sryburn/brewhoohoo-photon/README.md

A particle photon based HERMS brewery controller with 3D printed encousure.
WORK IN PROGRESS
