sryburn/brewhoohoo-photon/enclosure/BrewHooHoo_Case.obj

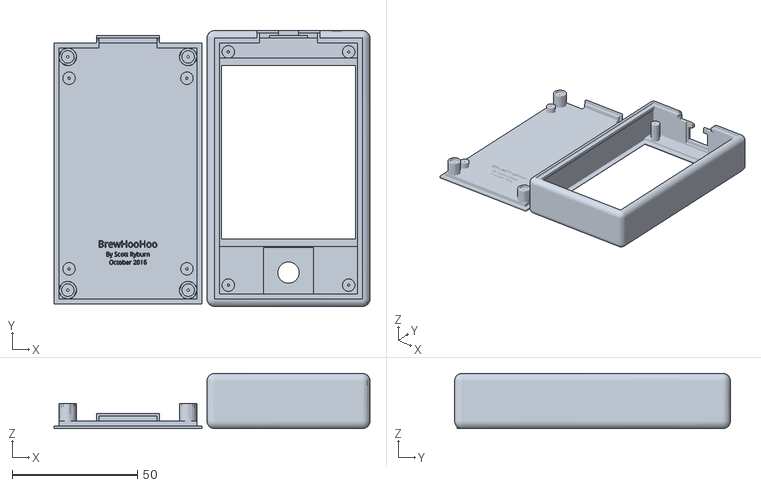
[picture p1: CAD file, 2017-02-18]
enclosure/BrewHooHoo_Case.obj
126.0 x 110.0 x 22.0
