sryburn/brewhoohoo-photon/schematics/relay_interface.pdf

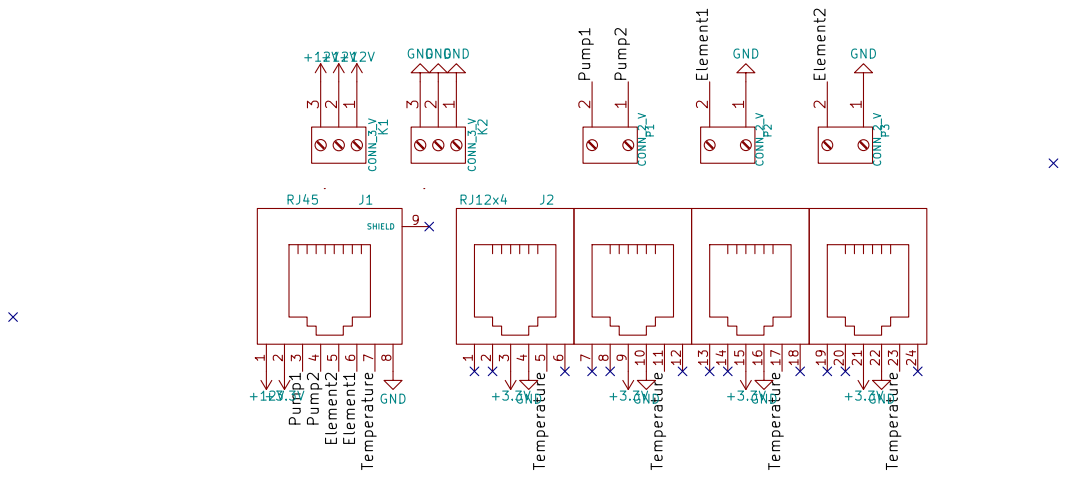
[picture p2: page 1]

File: brewbot_control_interface.sch Sheet: / github.com/sryburn

Id: 1/1 Title: BrewHooHoo Relay Interface
