sryburn/brewhoohoo-photon/schematics/photon_controller.pdf

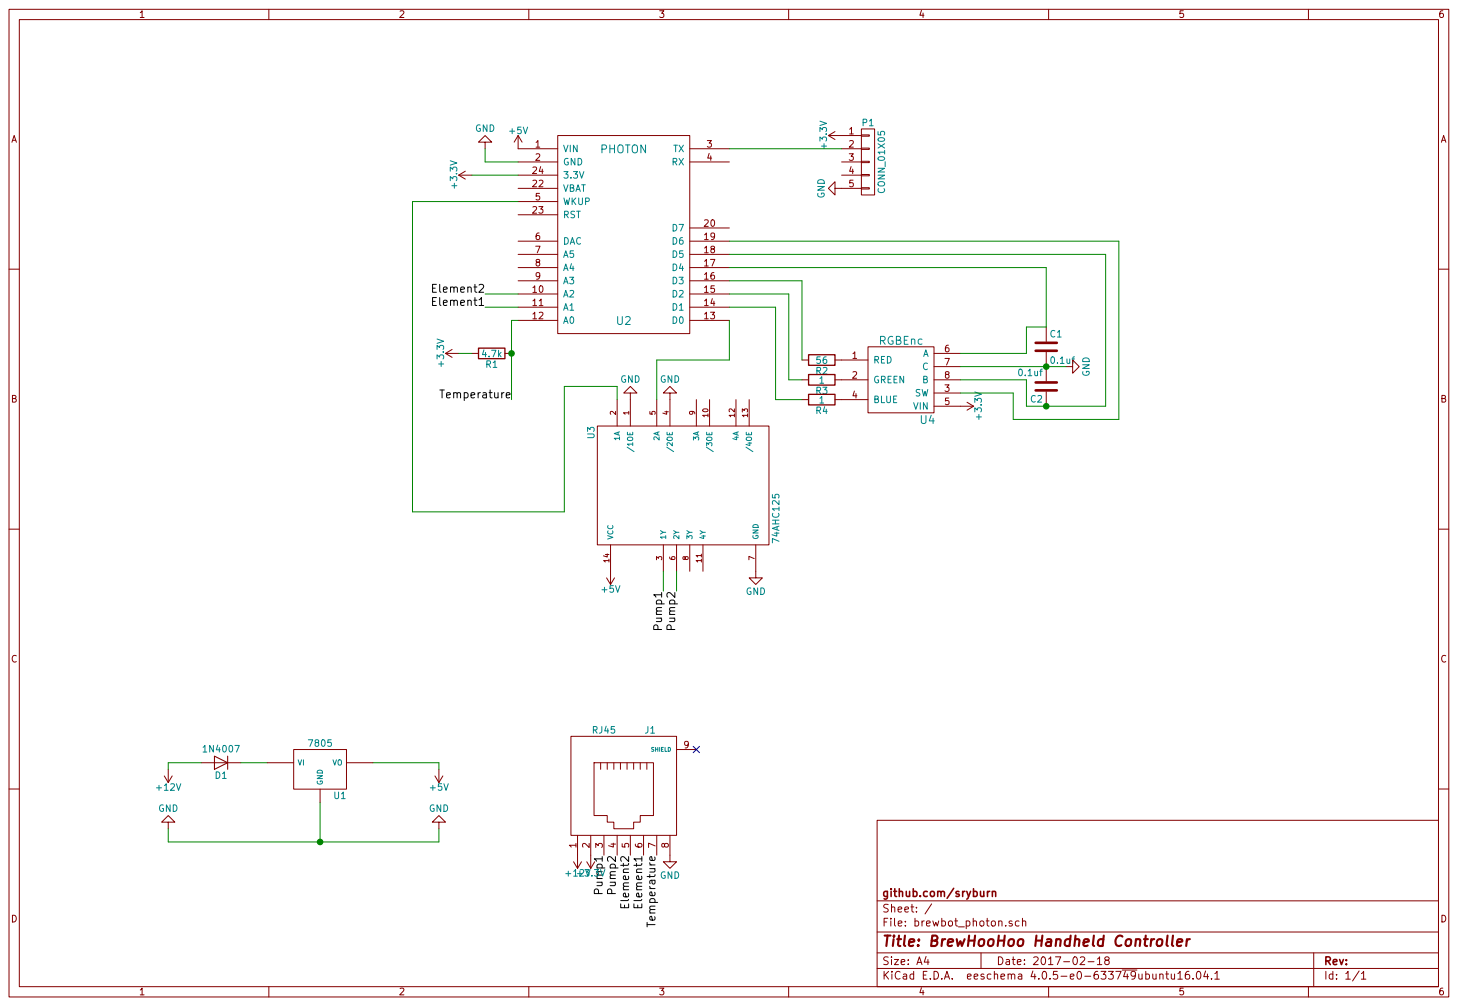
[picture p3: page 1]

File: brewbot_photon.sch Sheet: / github.com/sryburn

Id: 1/1 Title: BrewHooHoo Handheld Controller
