sryburn/brewhoohoo-photon/pcb/photon_controller.kicad_pcb

## KiCad design pcb/photon_controller.kicad_pcb (2017-02-18)

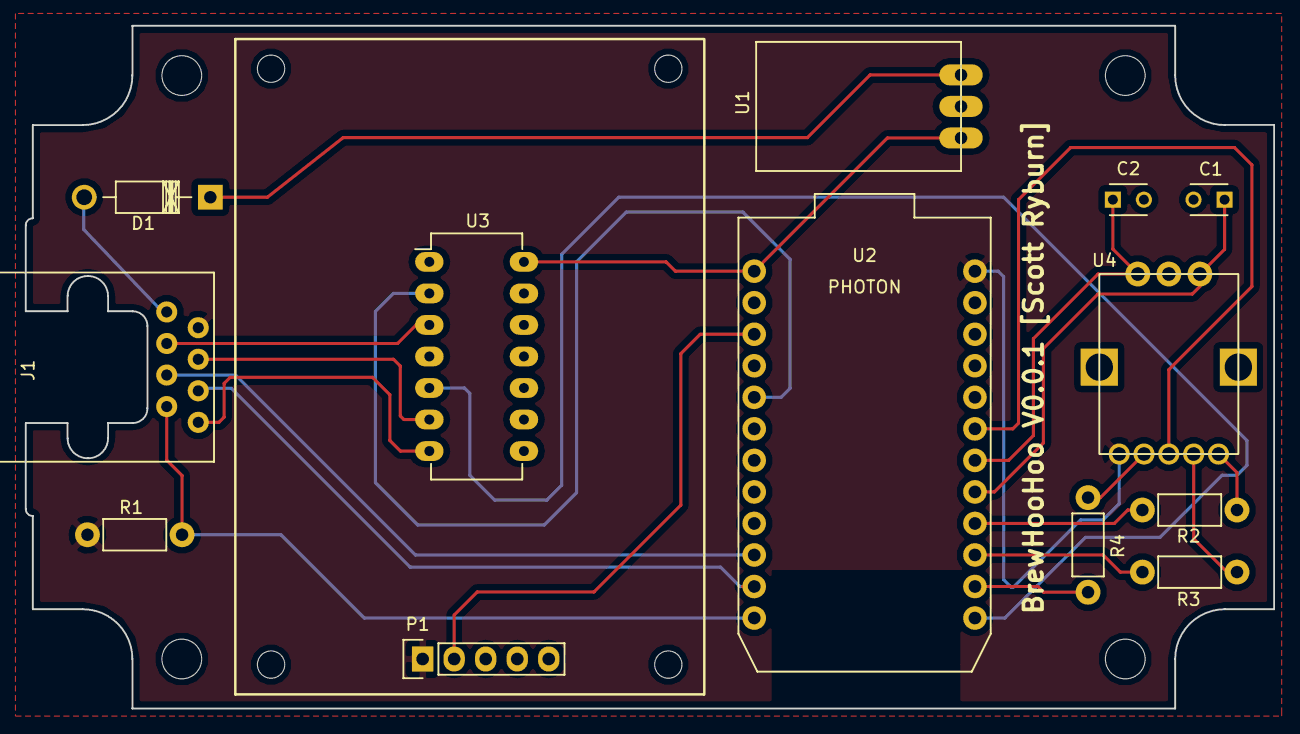
[picture p4: board photon_controller.kicad_pcb from above]

Board: 2 copper layers, 100.6 x 55.0 mm, 17 parts (0 on the bottom side), 22 nets.

Parts:
C1, C2: 0.1uf; C_Disc_D3_P2.5
D1: 1N4007; Diode_DO-41_SOD81_Horizontal_RM10
J1: RJ45; RJ45_cA121601-ND_slim
P1: CONN_01X05; Pin_Header_Straight_1x05
R1: 4.7k; Resistor_Horizontal_RM7mm
R2: 56; Resistor_Horizontal_RM7mm
R3, R4: 1; Resistor_Horizontal_RM7mm
U1: 7805; OKI-78SR-5-1.5-W36H-C
U2: PHOTON; photon
U3: 74AHC125; DIP-14_W7.62mm_LongPads
U4: RGBEnc; RGB_Encoder
h1, h2, h3, h4: MountingHole_2.2mm_M2

Connections:
+3V3: J1.2, P1.1, R1.2, U2.24, U4.5
+5V: U1.VO, U2.1, U3.14
+12V: D1.2, J1.1
/Element1: J1.6, U2.11
/Element2: J1.5, U2.10
/Pump1: J1.3, U3.3
/Pump2: J1.4, U3.6
/Temperature: J1.7, R1.1, U2.12
GND: C1.2, C2.2, J1.8, P1.5, U1.GND, U2.2, U3.1, U3.4, U3.7, U4.7
unnamed: C1.1, U2.17, U4.6
unnamed: C2.1, U2.18, U4.8
unnamed: D1.1, U1.VI
unnamed: P1.2, U2.3
unnamed: R2.1, U4.1
unnamed: R2.2, U2.16
unnamed: R3.1, U4.2
unnamed: R3.2, U2.15
unnamed: R4.1, U4.4
unnamed: R4.2, U2.14
unnamed: U2.5, U3.2
unnamed: U2.13, U3.5
unnamed: U2.19, U4.3
