sryburn/brewhoohoo-photon/pcb/relay_interface.kicad_pcb

## KiCad design pcb/relay_interface.kicad_pcb (2017-02-18)

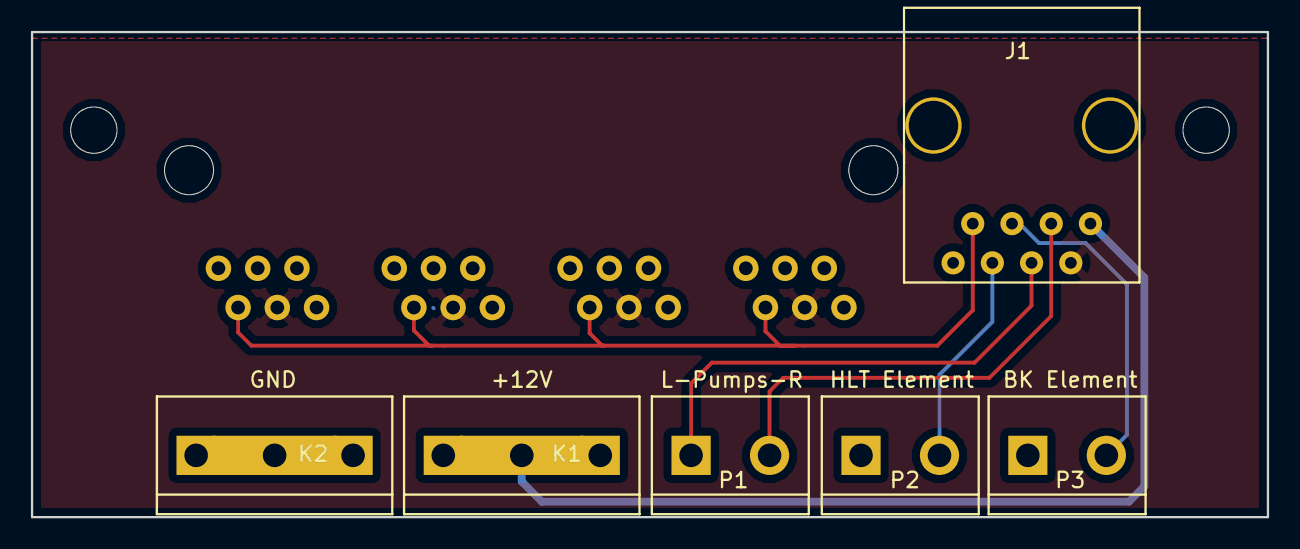
[picture p5: board relay_interface.kicad_pcb from above]

Board: 2 copper layers, 80.0 x 31.4 mm, 7 parts (1 on the bottom side), 8 nets.

Parts:
J1: RJ45; RJ45_c-bmj-0102
J2: RJ12x4; CT660027-RJ12
K1, K2: CONN_3_V; bornier3
P1, P2, P3: CONN_2_V; bornier2

Connections:
+3V3: J1.2, J2.3, J2.9, J2.15, J2.21
+12V: J1.1, K1.1, K1.2, K1.3
/Element1: J1.6, P2.2
/Element2: J1.5, P3.2
/Pump1: J1.3, P1.2
/Pump2: J1.4, P1.1
/Temperature: J1.7, J2.5, J2.11, J2.17, J2.23
GND: J1.8, J2.4, J2.10, J2.16, J2.22, K2.1, K2.2, K2.3, P2.1, P3.1
