sryburn/brewhoohoo-photon/(commit log)

2017-02-18 added PCBs
    [brewbot_control_fp.kicad_pcb, brewbot_control_interface.kicad_pcb, brewbot_photon.kicad_pcb]
2017-02-18 Added enclosure
    [BrewHooHoo_Case.obj]
2017-02-18 added schematics
2017-08-27 Add System thread
    -add support for system thread, network issues will no longer halt the loop
    -remove network connect/disconnect option
    -increased time between publish events to conform to publish webhook rate limit
    [brewhoohoo.ino]
2018-03-27 Add project properties file, Include libraries not available via particle cloud, restructure folders, update test probe addresses
2019-01-15 Implemented the ability to set a target mash temperature in place of an HLT setpoint with (very) basic control loop
